MakeMagazinDE/Taupunktluefter/Lochraster/Lochraster.md

# Lochraster-Version des Taupunktlüfters

**von Patrick alias _resipat265_ im [heise-Forum](https://www.heise.de/forum/Make/Heft-Projekte/Artikelforum-Heft-1-2022/Re-Taupunkt-Lueftungssystem-Bastelfrage/posting-41215886/show/)**

Hier ein Bild vom Ergebnis von oben:

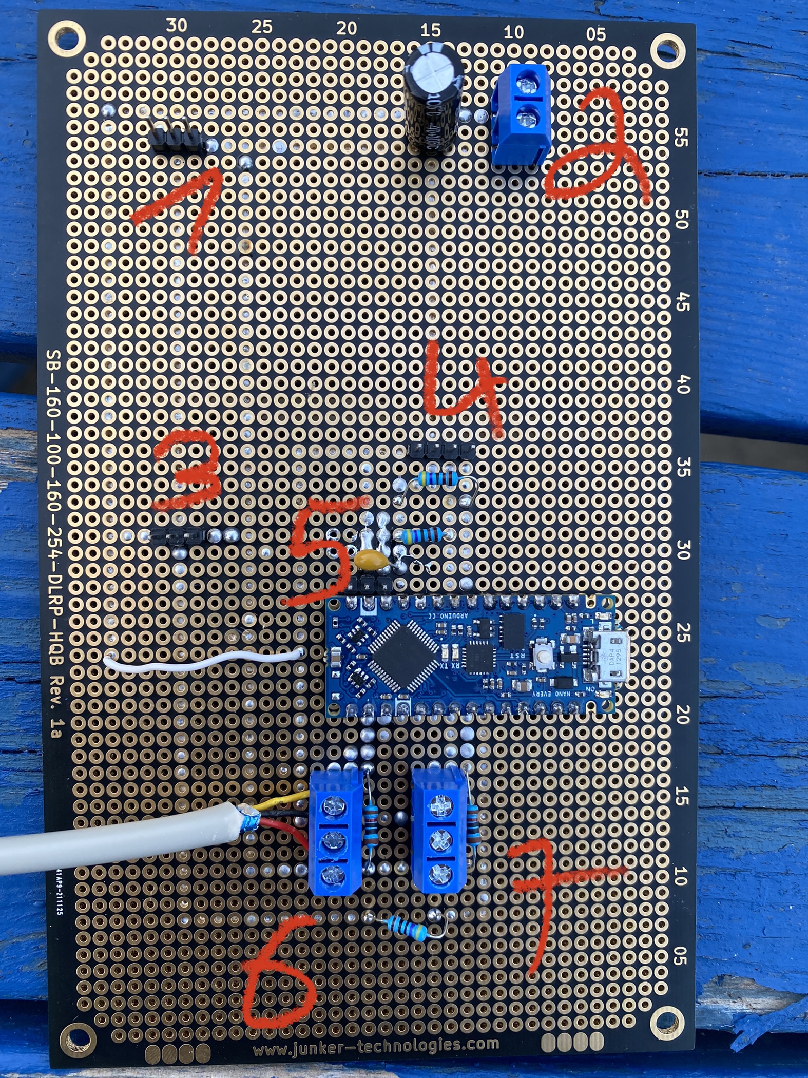
[picture p3: Lochraster/Lochraster_Draufsicht.jpg]
Draufsicht


Zu den Nummern, welche die Anschlüsse durchnummerieren:
1 = Relais-Anschluss
2 = VCC/GND Zuleitung von 5V Netzteil
3 = Modusschalter
4 = Displayanschluss
5 = Reset-Taster. Hier habe ich einen Pin zuviel gelötet…
6 = DHT22 außen
7 = DHT22 innen

Hier ein Bild von unten:

Untenansicht

Die drei [PDFs](./PDF) sind aus Fritzing exportiert, mit Gesamtschaltplan, Draufsicht und Sicht von unten. **Achtung**: Die Sicht von unten muss natürlich gespiegelt werden.
