MakeMagazinDE/Taupunktluefter/Lochraster/PDF/Lochraster_gesamtsicht.pdf

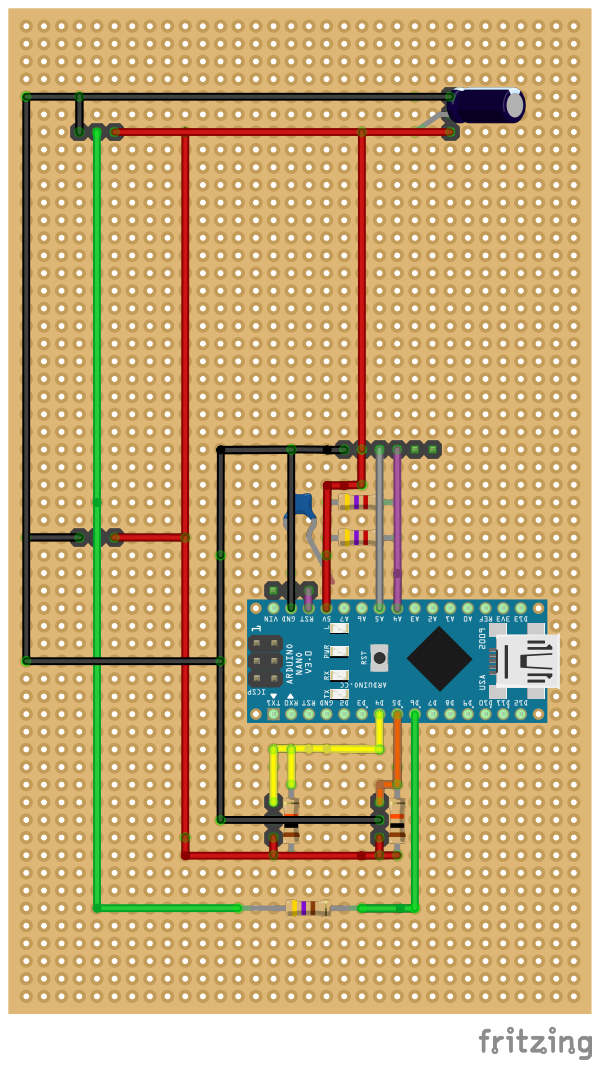
[picture p4: page 1]
