MakeMagazinDE/Taupunktluefter/Lochraster/PDF/Lochraster_oben.pdf

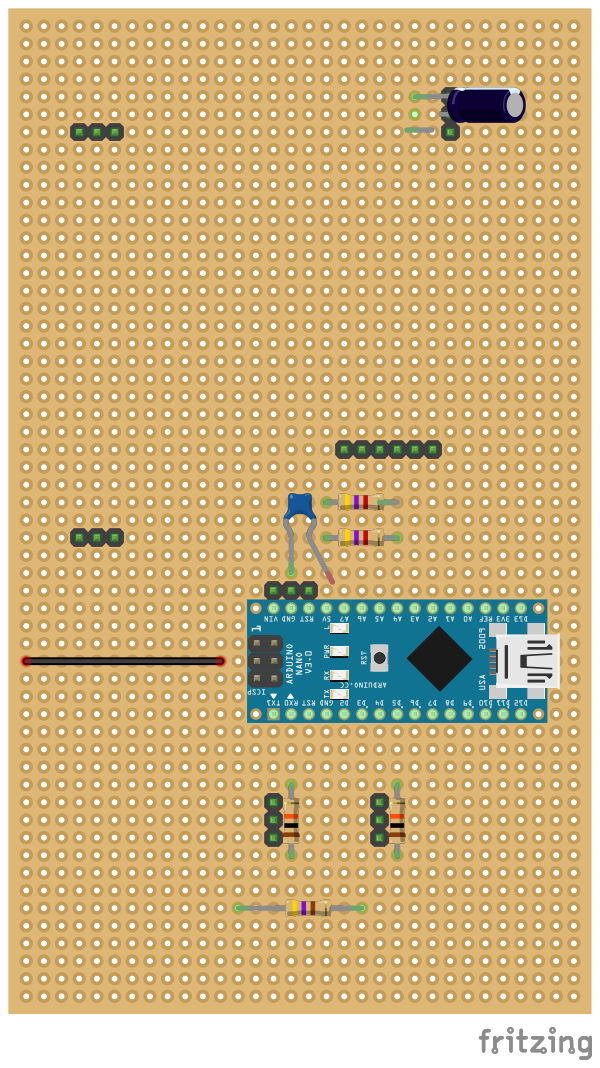
[picture p5: page 1]
