MakeMagazinDE/Taupunktluefter/Lochraster/PDF/Lochraster_unten.pdf

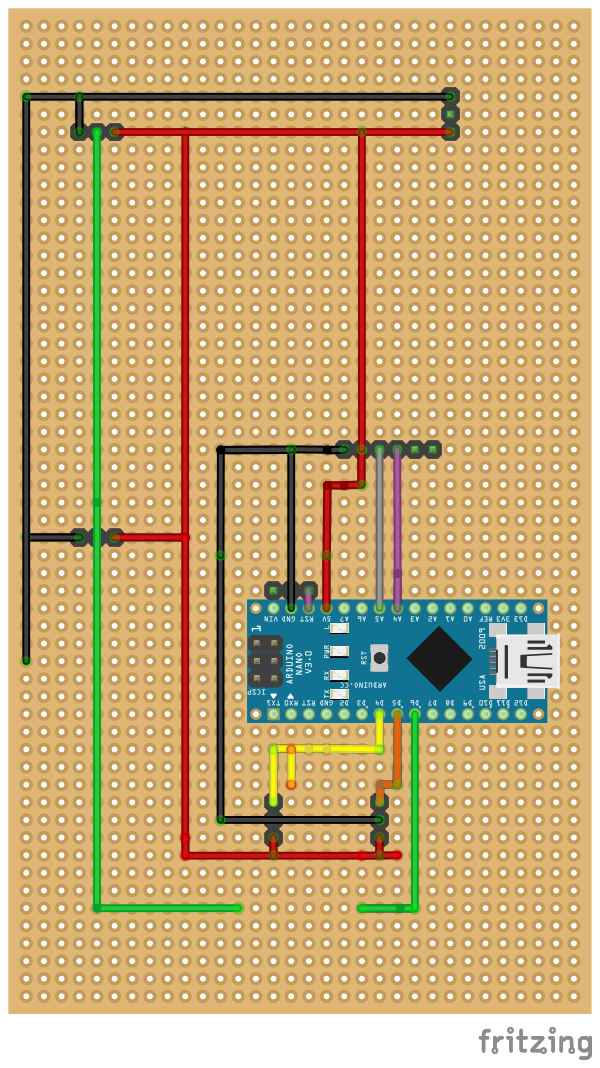
[picture p6: page 1]
