MakeMagazinDE/Taupunktluefter/(threads)

Thread 3 (2022-04-03):

i have a BME280 sensor, how to add actual hPa to calculation?

beta-tester, 2022-04-03:
hi,
i have a BME280 temperature, hunidity and pressure sensor.
where can i add the actual pressure [hPa] to the calculation of absolute hunidity and dew point temperature to make the result more accurate than calculation with a constant hPa pressure?

MakeMagazinDE, 2022-04-11:
Hi,
so sorry -- I guess, in this case you will have to do some research for the formulars and rewrite the calculation of the dew point completely.
-- pek

beta-tester, 2022-04-13:
where is your formular taken from?

Thread 4 (2022-04-12):

Sensor Erkennung funktioniert nicht richtig

kaukano1, 2022-04-12:
Das Programm wirft immer für einen Sensor "Fehler Sensor". Auch wenn ich für beide Anschlüsse den gleichen Sensor verwende, wird für einen Sensor eine Fehlermeldung geworfen.

kaukano1, 2022-04-13:
Wie immer lag der Fehler beim Anwender. Mein Breadboard (Brand New) hat eine Unterbrechung in der Stromversorgung.

Closed 2022-04-13.

Thread 5 (2022-04-14):

SAMD Anpassungen

Commifreak, 2022-04-14:
Ich wollte das Sketch auf einem Nano 33 IoT (SAMD) nutzen. Außer Watchdog ginge das auch.

Ich habe aber die LCD Bibliothek durch:

```ino
#include <hd44780.h>                        // main hd44780 header
#include <hd44780ioClass/hd44780_I2Cexp.h>  // i2c expander i/o class header
```

ausgetauscht (https://github.com/duinoWitchery/hd44780) und init durch begin ersetzt.

Statt Watchdog würde auf den SAMD `NVIC_SystemReset();` funktionieren.

Das einzige Problem was ich derzeit habe: Das Schalten des Relais, lässt nur noch Datenmüll auf dem Display stehen - oder es bleibt einfach an dem Punkt stehen. Ohne 230V Lüfter schaltet das Relais ohne das Display zu beeinflussen. Also Elektromagentische Störungen?

Die beiden Kondesatoren sind platziert. Was könnte ich noch versuchen?

Derzeit initialisiere ich das Relais am Ende des loops immer neu. Das hilft zumindest als Notlösung.

ThFischer, 2022-04-21:
> Die beiden Kondesatoren sind platziert. Was könnte ich noch versuchen?

Ein "Snubber" (a.k.a. "RC-Löschglied") sollte helfen, gibt es auch [in der Bucht](https://www.ebay.com/sch/i.html?_from=R40&_trksid=p2047675.m570.l1313&_nkw=Absorption+Snubber+Circuit&_sacat=0)

GitDriveHub, 2022-05-09:
Hallo, ich habe auch das Problem, dass sich das System nach jedem Einschalten des Lüfters aufhängt und anschließend in einer Schleife hängen bleibt. Wo wird der "Snubber" in der Schaltung eingebracht?
Zusätzlich zeigt mein Display nicht alle Infos vollständig an, woran kann das liegen?

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

Danke für die Hilfe, mit besten Grüßen

Thread 6 (2022-04-21):

Kompilatonsfehler

Schorsch71, 2022-04-21:
Hi,

Ich bin hier und auch bei Arduino Programmierung ganz neu dabei.
Früher C64 und AMIGA Erfahrung, so wie PC (eher Windows) und Hardwarezusammenbau.

Mein Problem ist, das ich bei der Kompilierung des hier angezeigten Codes eine Fehlermeldung bekomme.
Ich habe den Code mit Past und Copy in den Arduino IDE eingefügt und dann die benötigten Bibliotheken habe ich hinzugefügt.

Wähle ich ein Arduino UNO aus, geht die Kompilation durch, wähle ich mein Arduino Nano Every, so kommt die Fehlermeldung in Zeilen Nummer 38:
"WDTO_8S" was not declared in this scope

was ist falsch, bzw. was kann ich tun?

Brauche ich ein anderes Board?

MFK307, 2022-08-06:
Hi Schorsch,
ich hab selbiges Problem und auch noch keine Lösung gefunden. Hast du schon eine Lösung?

Gruss Mark

Schorsch71, 2022-08-06:
> Hi Schorsch, ich hab selbiges Problem und auch noch keine Lösung gefunden. Hast du schon eine Lösung?
>
> Gruss Mark

Hallo Mark,

es gibt keine Lösung, es klappt nur mit dem original Arduino nano!
Zumindest ohne Programmierkenntnisse und Anpassung an den every etc.
Ich hab mir zwei original nano gekauft, da ich die Lüftung zweimal baue und dann geht alles!

Ich hab auch die Entwickler und Publisher angeschrieben und keine Lösung erhalten!
Antwort: Ist für original nano gemacht!

Sorry,
so ist es nun mal. Viel Erfolg und Freude,
Schorsch

bodhinsky, 2022-08-23:
Hi Schorsch, Hi Mark,

kurzer Nachtrag (falls nicht schon gelöst) - es funktioniert wunderbar, wenn ihr "WDTO_8S" durch "WDT_PERIOD_8KCLK_gc" ersetzt. Siehe https://forum.arduino.cc/t/arduino-nano-every-and-wdto_8s/676107

Liebe Grüße,
Tim

Stephan-F-1122, 2023-08-28:
Ich hänge mich mal da dran, an die Überschrift Kompilationsfehler....

Diese Meldung bekomme ich:
Compilation error: 'RTC_start' was not declared in this scope

Ich habe versucht die DS1307RTC Library als ältere version zu installieren, keine Verbesserung. Dann gingen mir die Ideen schon aus, weil ich von der Programmierung so gar keine Ahnung habe....

Stephan-F-1122, 2023-08-29:
Falls hier noch jemand dasselbe Problem hat....
die Dateien SD.ino und Zeit.ino müssen im selben Verzeichnis sein wie die Taupunkt_Lueftung_Datenlogging_Version_2.13/Taupunkt_Lueftung_Datenlogging_Version_2.13.ino
Dann klappt das auch mit dem Kompilieren

commitcompanion, 2024-08-14:
if youre using an avr microcontroler, there is another method to implement watchdog. also keep in mind that on your arduino the pins are maybe diffrent. Here is a version of the avr compatible code(at least on an avr arduino nano, should work on others to):
https://github.com/commitcompanion/Taupunktluefter/blob/main/README.md
or on codeberg:
https://codeberg.org/comitcompanion/Taupunktluefter_avr

Thread 7 (2022-05-18):

Display und Hänger durch Lüfter

GitDriveHub, 2022-05-18:
Hallo, ich habe auch das Problem, dass sich das System nach jedem Einschalten des Lüfters aufhängt und anschließend in einer Schleife hängen bleibt. Wo wird der "Snubber" in der Schaltung eingebracht?
Zusätzlich zeigt mein Display nicht alle Infos vollständig an, woran kann das liegen?

image

Danke für die Hilfe, mit besten Grüßen

badbyte7, 2022-06-22:
Weil ich gerade darüber gestolpert bin, und die Frage noch nicht beantwortet ist:
https://www.mikrocontroller.net/articles/Snubber
https://en.wikipedia.org/wiki/Snubber

koozala, 2022-08-14:
Mit angeschlossenem Ventilator sind bei mir ebenfalls Störungen aufgetreten, die sich auf dem Display bemerkbar gemacht haben. Der Text war dann überhaupt nicht mehr lesbar. Obwohl im Original-Artikel angedeutet wird, dass die Störungen behandelt werden, finden sich dort leider keine Details. Ich habe daher versucht, mich in die Snubber-Thematik einzulesen. Mir hat dieser Forumsbeitrag sehr geholfen:
[https://forum.arduino.cc/t/unklarheiten-aufgetaucht-snubber-fur-kleine-pumpe/590316](https://forum.arduino.cc/t/unklarheiten-aufgetaucht-snubber-fur-kleine-pumpe/590316)
Zur Dimensionierung habe ich verschiedenes gefunden, da ich aber die Eigenschaften des Ventilators nicht kenne, wäre eine genaue Berechnung wohl auch nicht möglich. Daher habe ich einfach mal probiert. Als Widerstand für den Snubber verwende ich einen 5W-Hochlastwiderstand mit 180 Ohm, der Kondensator ist ein X2-Modell und hat 0,47 uF. Zusätzlich ist noch ein Varistor S14K385 verbaut. Ob das letztlich korrekt dimensioniert ist, weiss ich nicht (falls das jemand sagen kann, wäre ich für Feedback dankbar). Damit verschwinden die Störungen jedenfalls.

Gegenüber dem Original habe ich weitere Änderungen gemacht, z.B. verwende ich zur Display-Ansteuerung 4 Datenleitungen, nicht I2C.

Ganz fehlerfrei funktioniert das Ganze leider nocht nicht... ein Sensor ist mit einem recht langen Kabel angeschlossen (ca. 20m). Das Kabel ist geschirmt, dennoch vermute ich, dass darüber eine Störung ins System kommt. Das äussert sich darin, dass eine "0" an einer Position (immer dieselbe) auf dem Display erscheint, wo eigentlich keine hingehört. Vielleicht gibt es aber noch eine andere Ursache...

Mein Schaltplan sieht so aus (als Sensoren sind DHT22 verbaut, anders als dargestellt). Der Snubber ist rechts unten zu sehen:
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

koozala, 2022-09-17:
Die Snubber-Schaltung in meinem Schaltplan vom 14. August hat den Nachteil, dass sie über dem Schalter angeordnet ist. Das bedeutet, es fliesst ein Strom auch bei ausgeschaltetem Relais. Das hat zur Folge, dass der Lüfter, den ich mir nun besorgt habe, auch bei offenem Relais läuft... mit meinen anderen Testgeräten (einem Zimmer-Ventilator und einer Glühlampe) passiert das nicht. Wieder was gelernt... daher habe ich die Schaltung geändert und den Snubber nun über der Last angeordnet. Glücklicherweise musste ich dazu in meinem Aufbau nur eine Verbindung neu ziehen. Der Schaltplan sieht nun so aus (mit fritzing habe ich so meine Probleme, daher stimmen die Bezeichner nicht, was ich als Notiz vermerkt habe):
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

Oxi75, 2022-11-13:
Ich hatte und habe immer noch so einige Probleme mit der Schaltung:
1) Wenn ich den Lüfter angeschlossen habe, meldeten beiden Sensoren "Fehler". Das Problem konnte ich lösen, in dem ich parallel zum Lüfteranschluss einen 0.33µF X2 Kondensator geschaltet habe. Ich habe nicht lange gerechnet, sondern einfach in die Kiste gegriffen und es hat funktioniert :-)
2) in ca. 1m Abstand zur Steuerung habe ich eine Doppelschleifmaschine. Schalte ich diese ein, gehen die Sensoren wieder auf "Fehler". Der automatische Reset hilft nicht, die Schaltung geht in eine Endlos-Reboot-Schleife. Ich plane eine Modifikation der Schaltung, bei der die Sensoren über einen freien Digital-Out versorgt werden. Dann kann ich die Sensoren auch ganz aktiv stromlos machen.

Ansonsten habe ich die Schaltung auf KiCad gezeichnet und ein Layout erstellt ... für den Fall, dass jemand Interesse hat.

koozala, 2022-11-13:
@Oxi75: wie lange ist die Leitung, mit der du die Sensoren angeschlossen hast? Ist diese geschirmt?
Mein Aussensensor ist über eine ca. 15m lange, geschirmte Leitung angeschlossen und die Datenübertragung funktioniert gut. Ich habe allerdings auch keine Störsender (Motoren) in der Nähe...
Allerdings habe ich ein anderes Problem festgestellt... die Daten der Sensoren sehen zwar gut aus, sind aber falsch. Ich habe die Offsets zur Datenkorrektur bei Zimmertemperatur ermittelt, an Hand eines Referenz-Hygro-/Thermometers. Das reicht aber nicht aus, fürchte ich. Erstens ist das Referenzgerät mist, wie ich mittlerweile gemerkt habe (wohl zu billig), und zweitens reicht ein einzelner Offsetwert wahrscheinlich nicht aus. Daher werde ich nun versuchen, die Sensoren besser zu kalibrieren. Ist aber noch nicht fertig...

Oxi75, 2022-11-14:
@koozala: Also die eine Leitung ist vielleicht 50cm lang, die andere ca. 1m - also ziemlich kurz. Aber sie sind ungeschirmt was sicher nicht optimal ist. Bisher gab es auch keine Probleme außer wenn in der Umgebung ein Motor angesprungen ist. Das war meistens das Schleifgerät aber mindestens einmal auch etwas anderes ... Garagentorantrieb, Bohrmaschine, ... (ich war nicht dabei).

Ja, das mit den Sensoren ist mir auch aufgefallen. Ich habe zwei Temperaturmessgeräte in der Nähe und beide zeigen deutlich höhere Werte als der Innensensor DHT22 an. Was etwas Verbesserung gebracht hat, war den Innensensor von der Wand zu lösen. Ich vermute, dass diese als Außenwand aktuell die gemessene Temperatur nach unten zieht. Ich werde daher noch noch eine Styroporschicht einbringen. Aber den verbleibenden Unterschied kann ich mir nicht so recht erklären. Die Frage ist allerdings, ob das alles viel ausmacht, solange beide Sensoren unter identischen Bedingungen die selben Werte anzeigen.

Oxi75, 2022-11-27:
@koozala : Wie weit liegen denn bei Dir die Daten von den echten Werten entfernt?
Nach Datenblatt müssten die Sensoren ja relativ genau sein. Bei der Temperatur werden mir rund 1.5°C zu wenig angezeigt - das lässt sich aber noch mit der kalten Wand erklären auf die der Sensor geschraubt ist (Styropor als Zwischenlage hat hier deutlich geholfen). Aber die Luftfeuchtigkeit liegt bei ca. 10°C Temperatur rund 15 Prozentpunkte höher im Vergleich zu meinen Referenzmessgeräten. Diese sind zwar auch ziemlicher Billigkram aber es sind drei Stück - unterschiedlich alt, aus unterschiedlichen Quellen und die drei sind sich recht einig. Also vermute ich mal, dass der DHT22 der ist, der daneben liegt. Die niedrigere Temepratur erklärt im Übrigen nicht die höhere relative Luftfeuchtigkeit. Das wären nur wenige Prozentpunkte.

Oxi75, 2022-12-09:
@koozala: Ich habe mir noch ein analoges Hygromether bestellt. Seine Werte passen wiederrum sehr gut zu denen des DHT22. Sehr verwirrend. Wie siehts denn bei Dir aus?

koozala, 2022-12-09:
@Oxi75: Bei mir hat sich mittlerweile ein ganzer Zoo an Geräten angesammelt... ich hatte ursprünglich ein (sehr günstiges) digitales Hygro-/Thermometer als "Referenzgerät" genutzt. Allerdings hatte ich das im Verdacht, keine wirklich korrekten Werte anzuzeigen. Also habe ich mir weitere besorgt... ein weiteres digitales Gerät und ein analoges. Im direkten Vergleich zeigen alle drei Geräte mehr oder weniger unterschiedliche Werte an:
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

Ich habe die Geräte bisher nur in Innenraumbedingungen "getestet". Einmal bei feuchtkaltem Wetter draussen gehabt mit sehr wilden Ergebnissen (leider nicht dokumentiert). Dabei hat das analoge Gerät (B) weit über die 100% ausgeschlagen. Als nächstes plane ich einen eher systematischen Test.

- Gerät A scheint das beste der drei zu sein. Die Feuchtigkeitswerte stimmen mit B überein. Die Temperatur scheint zu passen, aber das kann ich noch nicht 100%-ig sagen.
- Bei Gerät B (analog) funktioniert die Feuchtigkeitsmessung, aber das Thermometer steht immer auf 20 Grad, egal bei welcher Temperatur. Das ist also eindeutig defekt.
- C war mein erstes Gerät, hier scheint nur die Temperaturanzeige halbwegs zu passen.

Nachteilig ist, dass alle drei Geräte vom selben Hersteller stammen. Darauf habe ich bei der Bestellung nicht geachtet, aber bei dem, was man so bei verschiedenen Händlern bestellen kann, ist es echt schwer, ein Qualitätsgerät zu identifizieren. Da schienen diese Geräte noch die besten zu sein.

Neben den DHT22-Sensoren habe ich mir noch HTU21-Sensoren besorgt. Nach ersten Versuchen ist schon mal klar, dass die alle unterschiedliche Werte anzeigen, mit hohen Abweichungen zu meinem Gerät A. Die müssen also kalibriert werden. Das gehe ich als nächstes an... Hier plane ich, eine standardisierte Umgebung durch eine Salzlösung herzustellen und als zweiten Kalibrierungspunkt eine 100%-Luftfeuchte, beides bei Raumtemperatur. Mal sehen, was ich mit einfachen Mitteln noch hinbekomme.

Oxi75, 2022-12-11:
@koozala : Ich bin gespannt was bei Deinen Untersuchungen heraus kommt.
Ich habe mir einen Dreierpack an elektronischen Thermometer-Hygromether-Kombinationen bei einem bekannten Discounter gekauft. Die drei sind sich recht einig aber passen im Bezug auf die Feuchtigkeit überhaupt nicht zu dem DHT22 - allerdings zu einem anderen Smart-Home-Gerät das ich schon länger habe. Das analoge passt dagegen recht gut - aber bisher habe ich es nur bei mir in der Garage testen können - und die ist entsprechend dem aktuellen Wetter recht konstant kalt.

koozala, 2022-12-12:
So, der erste Kalibrierungslauf ist jetzt seit knapp zwei Tagen aktiv. Hier sind zwei DHT22-Sensoren (S1 und S2) aufgetragen. Diese befinden sich in einem Behältnis mit Kochsalz-Lösung (a.k.a. Pampe). Soll-Wert der Luftfeuchtigkeit sollte durchgängig bei 75% liegen. S1 liegt da schon sehr nahe dran.

Der Ausreisser nach unten gestern Abend ca. 21:30 Uhr liegt daran, dass ich das Behältnis kurz geöffnet habe, um ein weiteres Hygrometer reinzustellen, in diesem Fall mein analoges (B). Dieses zeigt tatsächlich einen Wert wie S1 an, zumindest meistens...

Die Geräte A und C befinden sich ebenfalls im Versuchsaufbau. C zeigt wie erwartet keine brauchbaren Werte. A liegt bei ca. 71%, wenn B und S1 bei 74% liegen.

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

Kapazitive Luftfeuchtigkeits-Sensoren haben wohl eine Toleranz von bis zu 5%. Mein Versuchsaufbau ist sicher nicht ideal (Glasschüssel mit Küchenfolie drauf; kein Ventilator im Inneren, der die Luft durchmischt). Dadurch sind evtl. die Schwankungen in den Messungen erklärbar.  Temperaturschwankungen könnten auch einen Einfluss haben (auch wenn die Sollgrösse bei Kochsalz recht stabil über die Temperatur sein sollte). Ich erkläre mir das dadurch, dass die Kochsalzlösung träger ist als die Temperaturänderung. Dadurch dauert es bei Temperaturänderungen etwas, bis die Sollgrösse erreicht ist.  Eine gleichmässige Temperatur bekomme ich nicht ohne weiteres hin, daher muss ich mit diesen Werten weiterarbeiten.

Einen ähnlichen Aufbau werde ich noch mit Magnesiumchlorid versuchen, hier ist die Soll-Feuchtigkeit bei 33%. Und dann nochmal bei 100%. Dann schauen wir mal, wie die Kalibrierungsfunktion aussehen soll...

koozala, 2023-01-01:
Ich habe mich bei meinem Genauigkeitstest der Sensoren an dem orientiert, was Robert Smith durchgeführt hat: [Test and Calibrate DHT22 Hygrometers](https://www.kandrsmith.org/RJS/Misc/Hygrometers/calib_dht22.html). Ich habe mich dabei auf drei Messpunkte beschränkt, da die entsprechenden Salze (Magnesiumchlorid und Kochsalz) billig zu beschaffen sind. Die 100% Luftfeuchtigkeit habe ich einfach durch ein nasses Handtuch im verschlossenen Behälter hergestellt. Die Temperatur in der Testumgebung habe ich nicht kontrolliert, diese entspricht der Raumtemperatur und schwankt entsprechend (siehe obiges Diagramm).

Nach mehrtägigen Messungen lässt sich feststellen, dass die Temperaturschwankungen einen hohen Einfluss auf das Messergebnis haben. Ich nehme an, dass die Salzlösung teilweise nicht "hinterherkommt", die Soll-Luftfeuchtigkeit herzustellen, wenn sich die Temperatur zu schnell ändert. Dadurch erhält man entsprechende Abweichungen. Dennoch gibt es stabile Bereiche, so dass man zumindest ungefähr die Abweichung des ermittelten Sensorwerts zum Sollwert ermitteln kann. Ich brauche es ja auch nicht auf das Zehntel genau, aber die Zielgenauigkeit sollte schon bei ungefähr +/- 1% des Sollwertes liegen.

Die Referenzwerte für jeden Sensor habe ich grafisch ermittelt, also letztendlich einen Wert festgelegt, der zu den Messwerten grafisch am besten "passt". Die Werte sind in dieser Tabelle eingetragen:

`Soll     33,0    75,5   100,0    (bei 20 Grad C)`
`DHT 1    34,9    73,5    99,9`
`DHT 2    32,6    69,8    99,9`
`DHT 3    33,0    68,9    99,9`

Mit diesen Werten kann ich nun für jeden Sensor eine Korrekturfunktion definieren. Hier beschränke ich mich auf eine lineare Korrektur zwischen den Messpunkten. Wie man sieht, messen alle Sensoren die 100% Luftfeuchtigkeit korrekt. Die Abweichung ist bei dem Sollwert von 75,5% am grössten. Mich würde interessieren, wie gross die Abweichung bei ca. 50% Luftfeuchtigkeit wäre, aber mir fehlt das geeignete Salz, um diesen Sollwert herzustellen.

Ich werde nun meinen Taupunktlüfter mit den Sensoren bestücken, für die ich die Korrekturwerte kenne und die Software entsprechend mit den Korrekturfunktionen aktualisieren. Dann hoffe ich auf gute Funktion in der Betriebsumgebung.

Oxi75, 2023-04-03:
Hallo @koozala
Eine sehr interessante und sehr aufwändige Messreihe, die Du da gestartet hast.
Was ich interessant finde: DHT 2 und 3 liegen bei 75% einigermaßen eng beieinander. DHT 1 fällt aus der Reihe. Könnte da ein Messfehler vorliegen oder wäre es denkbar, dass DHT 1 aus einer anderen Charge stammt?
Für die Taupunktmessung ist es ja eigentlich unerheblich, ob die absoluten Werte korrekt sind, solange alle Sensoren bei gleichen Bedingungen die selben Werte ausgeben.

misgitsim, 2025-06-11:
Ich habe kein mechanisches Relais zum Einsatz gebracht sondern ein SSR (Solid State Relay), hatte diese hier noch rumliegen: Sharp S202S11. Das verursacht von Beginn an keine Störung. Snubber nicht vergessen und im Script Relais-an auf high und Relais-aus auf low. Alternativ gibt es kleine SSR beim Ali sehr günstig !

Thread 10 (2023-01-11):

fatal error: avr/wdt.h: No such file or directory

fredfroh, 2023-01-11:
Nach Neuinstallation der Arduino IDE kommt beim Kompilieren die Fehlermeldung "fatal error: avr/wdt.h: No such file or directory".
Hab schon lange gesucht, finde aber keine Bibliothek. Die Fehlermeldung kommt in der Arduinovrsion 1.8.19 und auch 2.0.3.
Hat jemand tip?

Closed 2023-01-22.

Thread 13 (2024-07-07):

OLED Display

Prediculous, 2024-07-07:
Als absoluter newbie, habe ich versehentlich einen Arduino Nano mit integriertem OLED Display gekauft.
In der Hoffnung Platz und auch Geld zu sparen wollte ich das eben etwas anders umsetzen - leider bekomme ich den Code absolut nicht für ein OLED Display umgeschrieben - hat das schon jemand gemacht und kann mir weiterhelfen?

commitcompanion, 2024-08-14:
which arduino is it exactly?
